MaxLell/HALCO2/Docu/Progress Pictures/PHOTO-2022-04-22-09-54-37.jpg

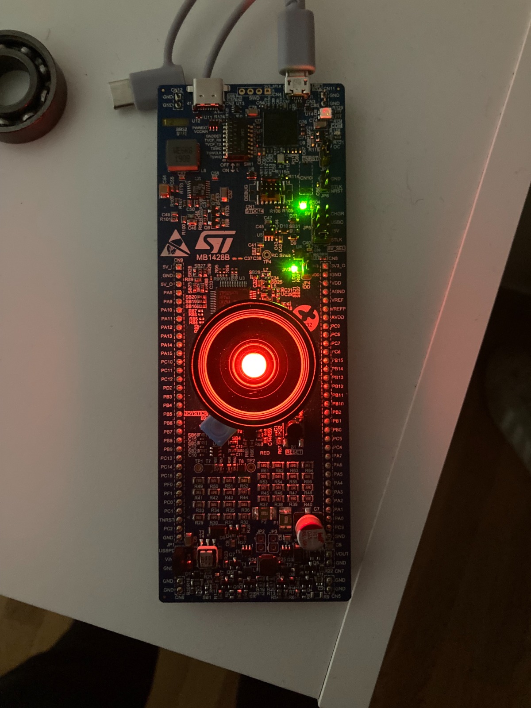
Docu/Progress Pictures/PHOTO-2022-04-22-09-54-37.jpg
