MaxLell/HALCO2/Docu/Architecture/Power Diagram.drawio.png

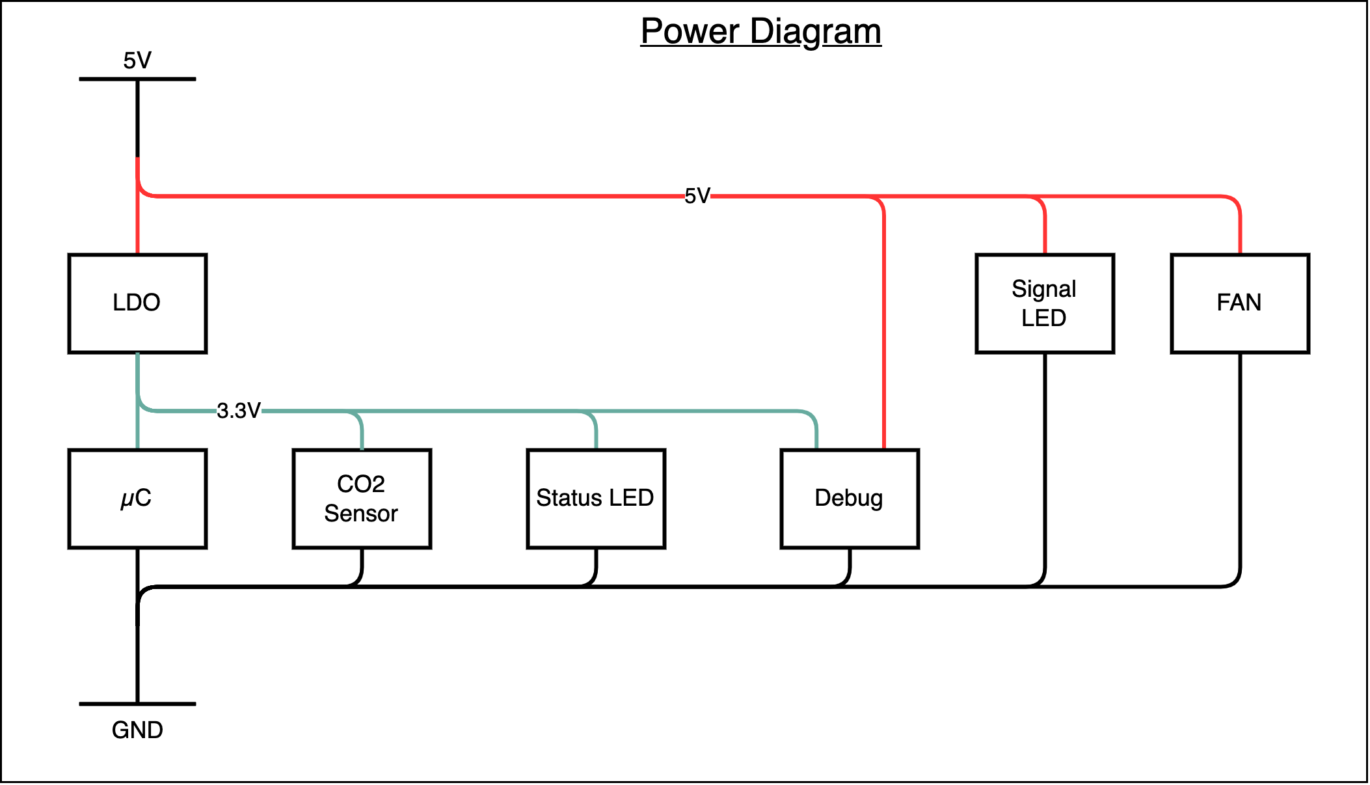
Docu/Architecture/Power Diagram.drawio.png
