MaxLell/HALCO2/Docu/Architecture/System Block Diagram.drawio.png

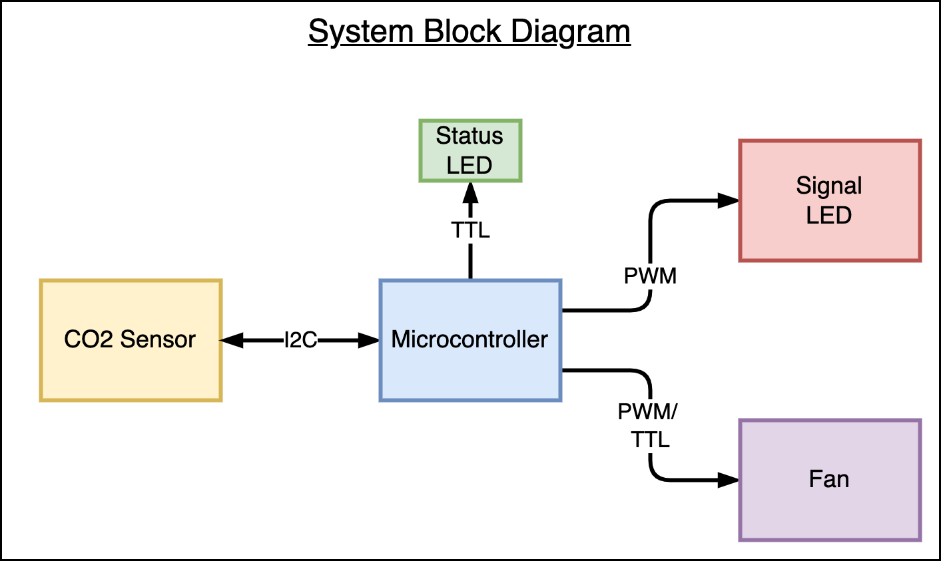
Docu/Architecture/System Block Diagram.drawio.png
