MaxLell/HALCO2/Hardware/BOM.md

## Additionally required Hardware Components:
- Fan: 40x40x10[mm] Fan like this one:
- Lens: Smartphone wideangle lens. The version used for HALCO is this one: [Link](https://www.aliexpress.com/item/1005003489247254.html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). But any other will do also. Just look on Aliexpress for the term "Smartphone Wideangle lens 235 degree". You should find the right lens for the setup
