MaxLell/HALCO2/Hardware/Housing/2022-09-28-V5/Spine.3mf

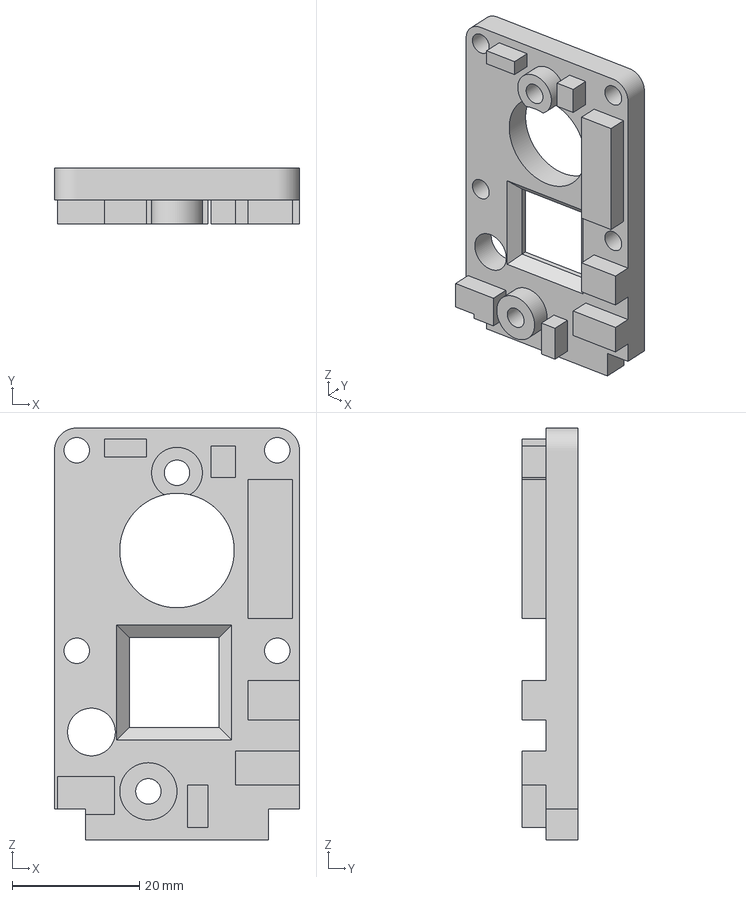
[picture p5: CAD file, 2022-10-04]
Hardware/Housing/2022-09-28-V5/Spine.3mf
38.5 x 8.80 x 64.8 mm
