MaxLell/HALCO2/Hardware/Housing/202206_25/TOP.3mf

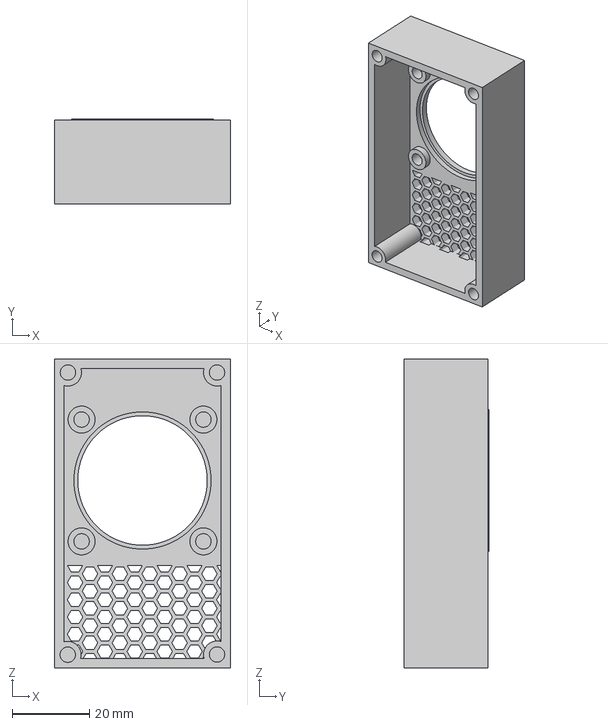
[picture p6: CAD file, 2022-09-27]
Hardware/Housing/202206_25/TOP.3mf
45.6 x 22.0 x 80.0 mm
