MaxLell/HALCO2/Hardware/Housing/202206_25/Body15.3mf

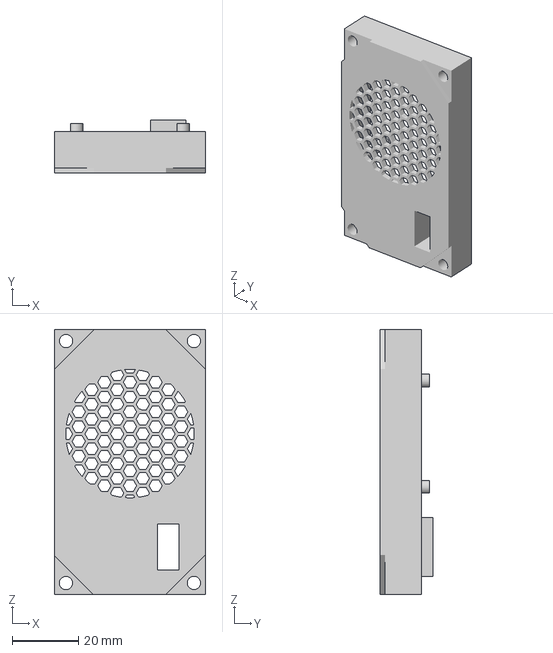
[picture p7: CAD file, 2022-09-27]
Hardware/Housing/202206_25/Body15.3mf
45.6 x 16.0 x 80.0 mm
