MaxLell/HALCO2/Hardware/Housing/2022-09-28-V5/Backside.3mf

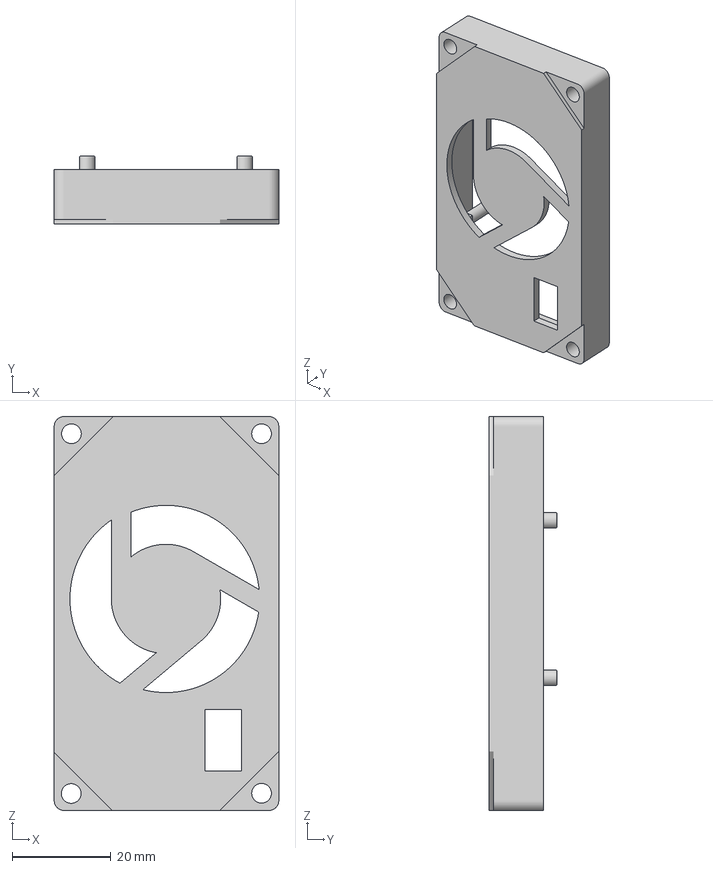
[picture p8: CAD file, 2022-10-02]
Hardware/Housing/2022-09-28-V5/Backside.3mf
45.6 x 13.9 x 80.0 mm
