MaxLell/HALCO2/Hardware/Housing/202206_25/Holder.3mf

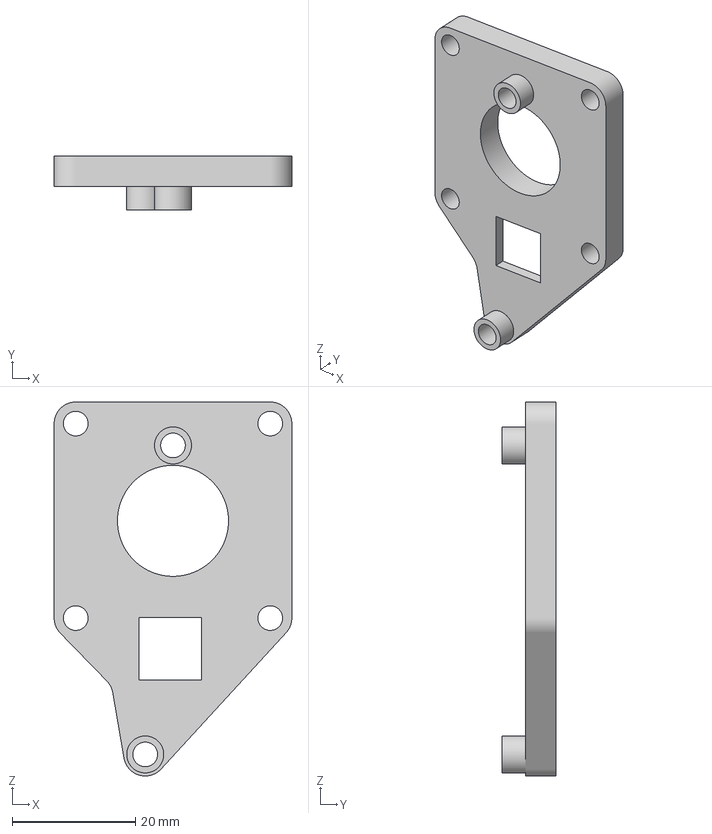
[picture p9: CAD file, 2022-09-27]
Hardware/Housing/202206_25/Holder.3mf
38.5 x 8.80 x 60.6 mm
