MaxLell/HALCO2/(list of files, cad)

Other CAD files:
Hardware/Housing/2022-09-28-V5/Frontside.3mf
Hardware/Housing/202206_25/Bot.3mf
