MaxLell/HALCO2/Hardware/PCBA/Co2_Sensor/Co2_Sensor.kicad_pcb

## KiCad design Hardware/PCBA/Co2_Sensor/Co2_Sensor.kicad_pcb (2022-09-27)

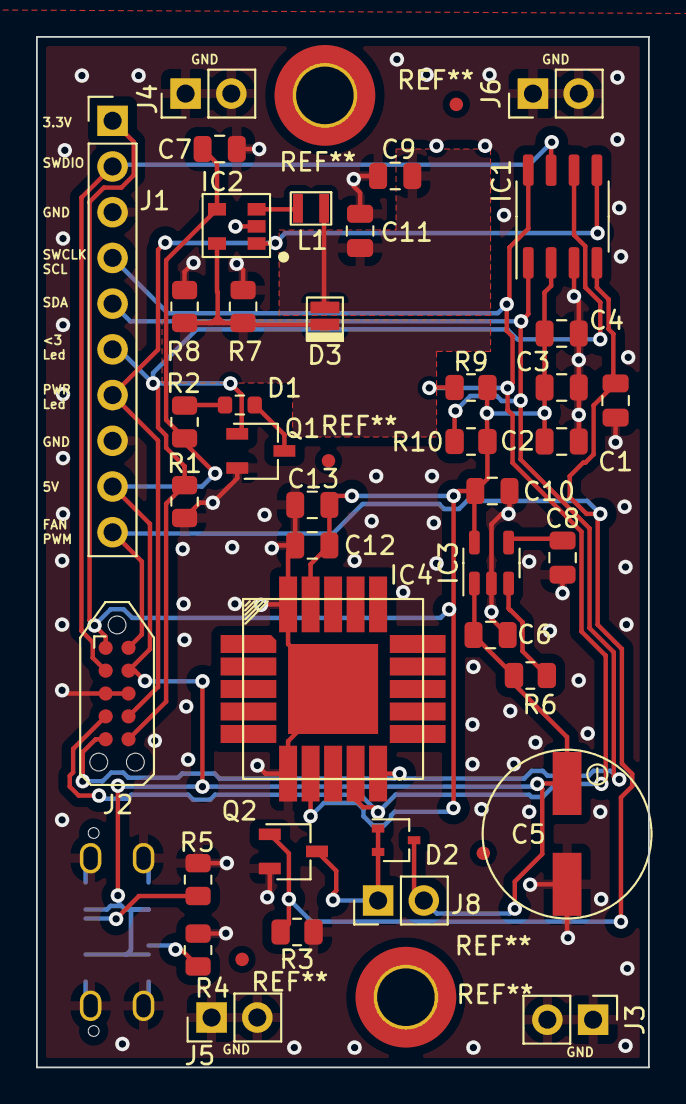
[picture p10: board Co2_Sensor.kicad_pcb from above]

Board: 2 copper layers, 34.0 x 57.2 mm, 41 parts (1 on the bottom side), 19 nets.

Parts:
C1, C4, C8, C11, C13: 100n; C_0805_2012Metric
C2, C7, C9: 10u; C_0805_2012Metric
C3, C6, C10, C12: 1u; C_0805_2012Metric
C5: 330u; Cap_Elko_330u_6V3
D1: R_0603_1608Metric
D2: DAN235FMT106; SOT-323_SC-70
D3: LED; Cree_SMD2
IC1: STM32G031J6; SO-8_3.9x4.9mm_P1.27mm
IC2: PAM2804; TSOT25
IC3: LDK120M33R; TSOT-23-5
IC4: SCD4X
J1: Conn_01x10_Male; PinHeader_1x10_P2.54mm_Vertical
J2: Conn_01x10; Tag-Connect_TC2050-IDC-NL_2x05_P1.27mm_Vertical
J3, J4, J5, J6, J8: PinHeader_1x02_P2.54mm_Vertical
J7: USB_C_Receptacle_JAE_DX07S024WJ3R400
L1: 4u7; SRP2010DPA-4R7M
Q1, Q2: Q_NMOS_GSD; TSOT-23
R1, R3, R4, R5, R6, R9, R10: 5k1; R_0805_2012Metric
R2: 270R; R_0805_2012Metric
R7: 6R8; R_0805_2012Metric
R8: 5R6; R_0805_2012Metric

Connections:
+3V3: C2.1, C3.1, C4.1, C10.1, C12.1, C13.1, IC1.2 (VDD), IC3.5 (VOUT), IC4.7 (VDD), IC4.19 (VDDH), J1.1, J2.1, R9.1, R10.1
+5V: C5.1, C6.1, C7.1, D2.3 (Kathode), IC2.4 (VIN), IC3.1 (VIN), J1.9, J2.9, J7.A4 (VBUS), J7.A9 (VBUS), J7.B4 (VBUS), J7.B9 (VBUS), J8.2, R2.1, R6.2
/Power_LedDriver_Fan/Power LED Anode: C9.1, C11.1, D3.2 (A), L1.2
/Power_LedDriver_Fan/Power LED Kathode: D3.1 (K), IC2.5 (FB), R7.1, R8.1
DcFan_TTL: C1.1, IC1.4 (PA0/PA1/PA2/PF2-NRST), J1.10, J2.10, Q2.1 (G), R3.1
GND: C1.2, C2.2, C3.2, C4.2, C5.2, C6.2, C7.2, C8.2, C9.2, C10.2, C11.2, C12.2, C13.2, IC1.3 (GND), IC2.2 (GND), IC3.2 (GND), IC4.6 (GND), IC4.20 (GND), IC4.21 (GND), J1.3, J1.8, J2.3, J2.8, J3.1, J3.2, J4.1, J4.2, J5.1, J5.2, J6.1, J6.2, J7.A1 (GND), J7.A12 (GND), J7.B1 (GND), J7.B12 (GND), J7.S1 (SHIELD), Q1.2 (S), Q2.2 (S), R1.2, R3.2, R4.2, R5.2, R7.2, R8.2
I2C_SCL: IC1.8 (PB5/PB6/PA14-BOOT0/PA15), IC4.9 (SCL), J1.4, J2.4, R9.2
I2C_SDA: IC1.1 (PB7/PB8/PB9/PC14-OSC32_IN), IC4.10 (SDA), J1.5, J2.5, R10.2
unnamed: C8.1, IC3.4 (BYP/ADJ/NC)
unnamed: D1.1 (K), Q1.3 (D)
unnamed: D1.2 (A), R2.2
unnamed: D2.1 (Anode), D2.2 (Anode), J8.1, Q2.3 (D)
unnamed: IC2.3 (SW), L1.1
unnamed: IC3.3 (EN), R6.1
unnamed: J7.A5 (CC1), R5.1
unnamed: J7.B5 (CC2), R4.1
SWDIO: IC1.7 (PA13), J1.2, J2.2
SignalLed_PWM: IC1.5 (PA8/PA11[PA9]/PB0/PB1), IC2.1 (EN), J1.7, J2.7
StatusLed_TTL: IC1.6 (PA12[PA10]), J1.6, J2.6, Q1.1 (G), R1.1
