MaxLell/HALCO2/Firmware/G031_CO2/G031_BoardBringUp/Core/Src/main.c

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
/* Includes ------------------------------------------------------------------*/
#include "main.h"

 TIM_HandleTypeDef htim2;

void SystemClock_Config(void);
static void MX_GPIO_Init(void);
static void MX_TIM2_Init(void);
/**
  * @brief  The application entry point.
  * @retval int
  */
int main(void)
{
  /* MCU Configuration--------------------------------------------------------*/

  /* Reset of all peripherals, Initializes the Flash interface and the Systick. */
  HAL_Init();

  /* Configure the system clock */
  SystemClock_Config();

  /* Initialize all configured peripherals */
  MX_GPIO_Init();
  MX_TIM2_Init();
  /* USER CODE BEGIN 2 */

  /*
   * This section needs to be executed once to set the right bit for the NRST Pin
   * https://github.com/olikraus/stm32g031/blob/main/disable_nrst/disable_nrst.c
   */
	/* check for the NRST GPIO mode */
	if ( (FLASH->OPTR & FLASH_OPTR_NRST_MODE_1) != 0 && (FLASH->OPTR & FLASH_OPTR_NRST_MODE_0) == 0 )
	{

	}

	/* Clear the LOCK bit in FLASH->CR (precondition for option byte flash) */
	FLASH->KEYR = 0x45670123;
	FLASH->KEYR = 0xCDEF89AB;
	/* Clear the OPTLOCK bit in FLASH->CR */
	FLASH->OPTKEYR = 0x08192A3B;
	FLASH->OPTKEYR = 0x4C5D6E7F;

	/* enable GPIO mode */
	FLASH->OPTR |= FLASH_OPTR_NRST_MODE_1;
	FLASH->OPTR &= ~FLASH_OPTR_NRST_MODE_0;

	/* check if there is any flash operation */
	while( (FLASH->SR & FLASH_SR_BSY1) != 0 )
		;

	/* start the option byte flash */
	FLASH->CR |= FLASH_CR_OPTSTRT;
	/* wait until flashing is done */
	while( (FLASH->SR & FLASH_SR_BSY1) != 0 )
		;

	/* do a busy delay, for about one second, check BSY1 flag to avoid compiler loop optimization */
	for( unsigned long i = 0; i < 2000000; i++ )
		if ( (FLASH->SR & FLASH_SR_BSY1) != 0 )
			break;

	/* load the new value and do a system reset */
	/* this will behave like a goto to the begin of this main procedure */
	FLASH->CR |= FLASH_CR_OBL_LAUNCH;


	// Enable the PowerLED and measure its consumption
	HAL_GPIO_WritePin(EyeLED_GPIO_Port, EyeLED_Pin, GPIO_PIN_SET);
	HAL_GPIO_WritePin(BlinkyLED_GPIO_Port, BlinkyLED_Pin, GPIO_PIN_RESET);
	//HAL_GPIO_WritePin(FanCTRL_GPIO_Port, FanCTRL_Pin, GPIO_PIN_RESET);
	HAL_TIM_PWM_Start(&htim2, TIM_CHANNEL_1);




	// HAL_GPIO_WritePin(FanCTRL_GPIO_Port, FanCTRL_Pin, GPIO_PIN_SET);

  /* USER CODE END 2 */

  /* Infinite loop */
  /* USER CODE BEGIN WHILE */
	while (1)
	{
    /* USER CODE END WHILE */

    /* USER CODE BEGIN 3 */


		HAL_GPIO_TogglePin(BlinkyLED_GPIO_Port, BlinkyLED_Pin);
		//HAL_GPIO_TogglePin(FanCTRL_GPIO_Port, FanCTRL_Pin);
		HAL_Delay(10000);


	}
  /* USER CODE END 3 */
}

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
