MaxLell/HALCO2/Firmware/G031_CO2/G031_BoardBringUp/G031_BoardBringUp.ioc

Mcu.UserName=STM32G031J6Mx
PA0.Signal=S_TIM2_CH1_ETR
