MaxLell/HALCO2/Firmware/G031_CO2/G031_BoardBringUp/Core/Inc/main.h

#define TestPIN3_Pin GPIO_PIN_14
#define TestPIN3_GPIO_Port GPIOC
#define EyeLED_Pin GPIO_PIN_11
#define EyeLED_GPIO_Port GPIOA
#define BlinkyLED_Pin GPIO_PIN_12
#define BlinkyLED_GPIO_Port GPIOA
