MaxLell/HALCO2/(commit log)

2022-09-27 Working Prototype
    - Created a tested PCBA
    - Created the Firmware including major clean up
    - Added a BoardBringUp Project, to test out the system
    - Added photos for documentation purposes
    [Body15.3mf, Bot.3mf, CO2Sensor.kicad_sch, Co2_Sensor.csv, Co2_Sensor.kicad_pcb, Co2_Sensor.kicad_sch, Holder.3mf, Led Driver and Power.kicad_sch]
2022-09-27 Project Setup Instructions
    - Added Bug fix details for the PCBA fabrication
    - Added Board-Bring-Up Instructions for the Firmware flashing process
2022-10-02 Add Hardware Files
    Added a Hardware Component BOM
    Added the 3D print files for HALCO2
    [Backside.3mf, Frontside.3mf, Spine.3mf]
2022-10-04 Added a 4th mode, where the Fan and the PowerLed are switched off; Code Refactoring
    - Added a 4th mode, which will be active during times, when the window is open (so during the night and during the day - this reduces the power consumption significantly and it should also increase the lifespan of the hardware components significantly, as this mode is usually active most of the times.
    - Refactored the code:
    - Created a new module for the fan
    - Move the logic, which was previously all stacked in the main into dedicated functions.
2022-10-04 Update the spine, to make it more durable; Improve the airflow through the housing so that it all passes the CO2 Sensor
    [Spine.3mf]
2023-11-05 Added an averaging filter; Removed Experimental Data from Repo (JS Code for Hysterese)
2023-11-05 Changed the animation for the worst air quality to be less annoying; resolved a minor bug fix - off-by-one-error
    [PowerLed.c, PowerLed.h]
