MaxLell/HALCO2/(notices)

Notices in the files:
Firmware/G031_CO2/G031_BoardBringUp/Core/Inc/main.h:
Copyright (c) 2022 STMicroelectronics.
All rights reserved.
This software is licensed under terms that can be found in the LICENSE file
